karlsander/paper-slot-processor/docs/images/v1.8-half-taper-base.png

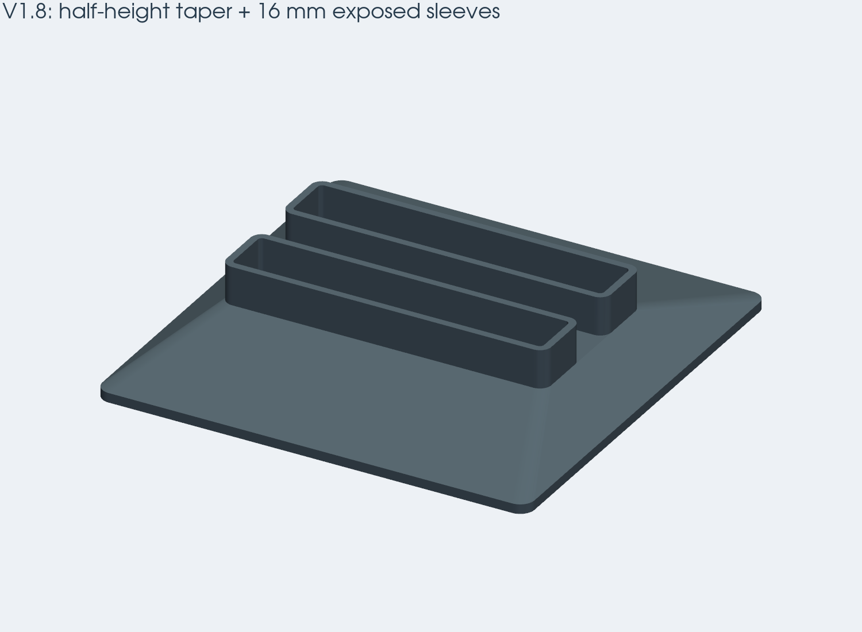
docs/images/v1.8-half-taper-base.png
