karlsander/paper-slot-processor/docs/negative-carrier-b2/forces/force-summary.png

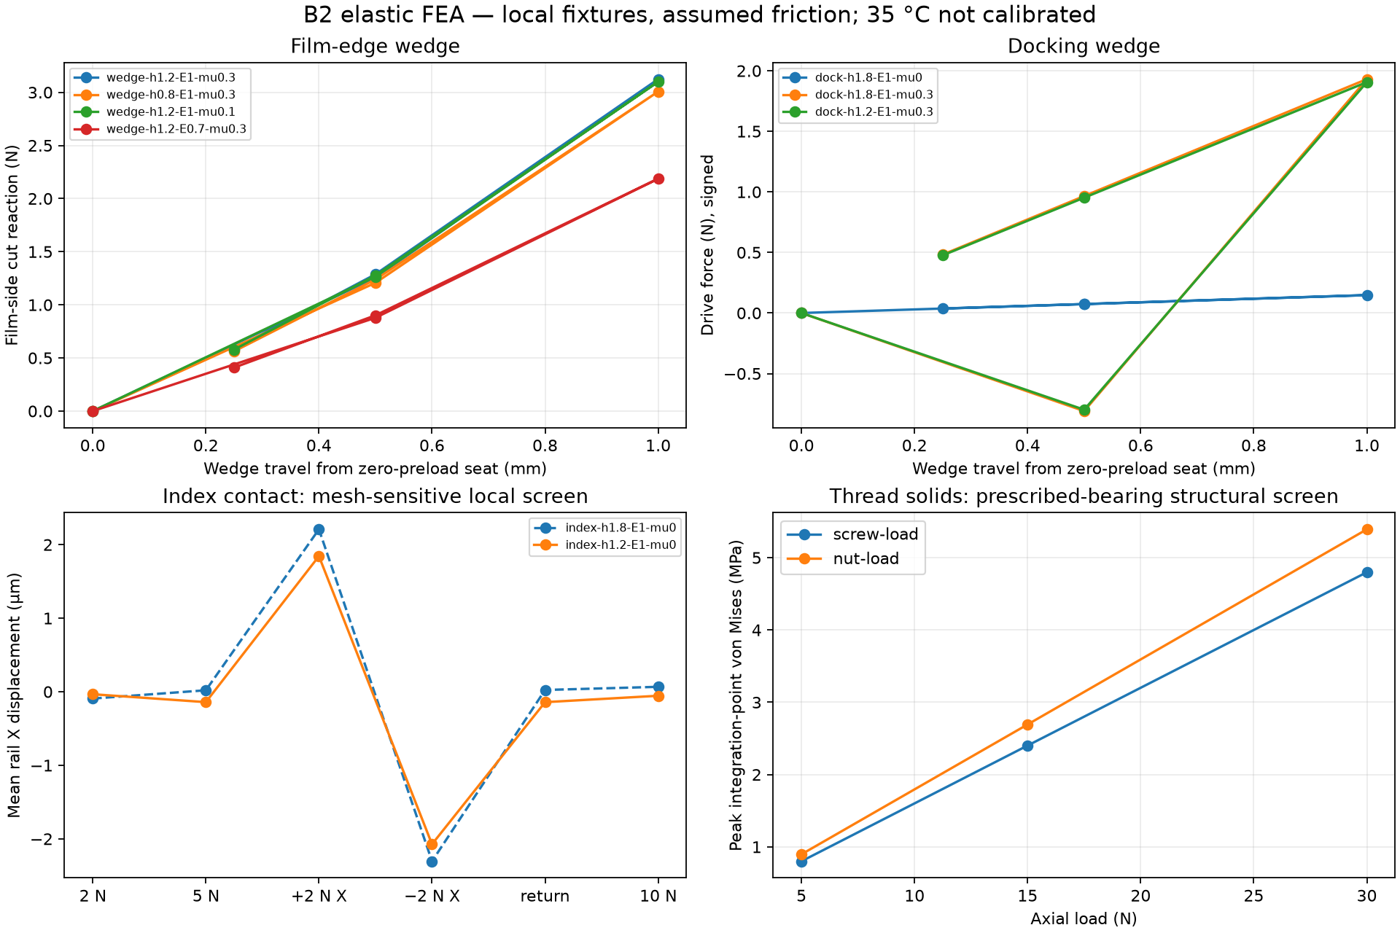
docs/negative-carrier-b2/forces/force-summary.png
