karlsander/paper-slot-processor/docs/negative-carrier-b2/videos/04-dock-preview.png

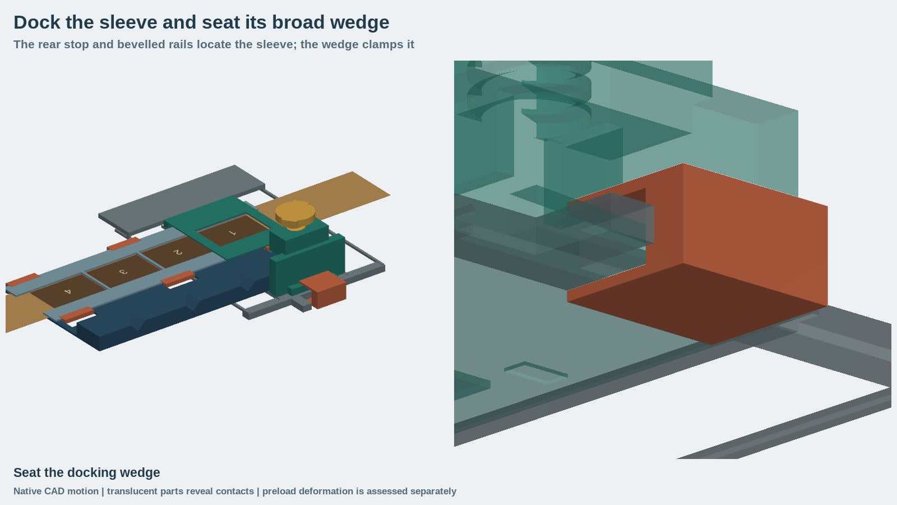
docs/negative-carrier-b2/videos/04-dock-preview.png
