karlsander/paper-slot-processor/docs/negative-carrier-b/forces/clip-catch-0.22.png

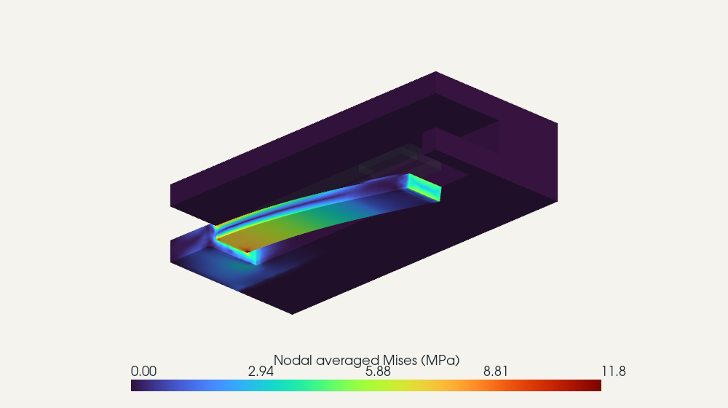
docs/negative-carrier-b/forces/clip-catch-0.22.png
