karlsander/paper-slot-processor/docs/negative-carrier-b/forces/contact-0.4-0.3-side1-compare.png

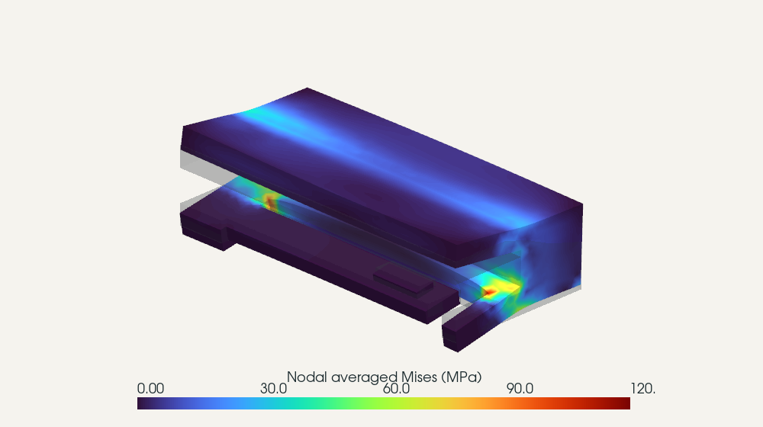
docs/negative-carrier-b/forces/contact-0.4-0.3-side1-compare.png
