karlsander/paper-slot-processor/docs/negative-carrier-b/forces/contact-0.55-0.3-side1-mates20-mortar-compare.png

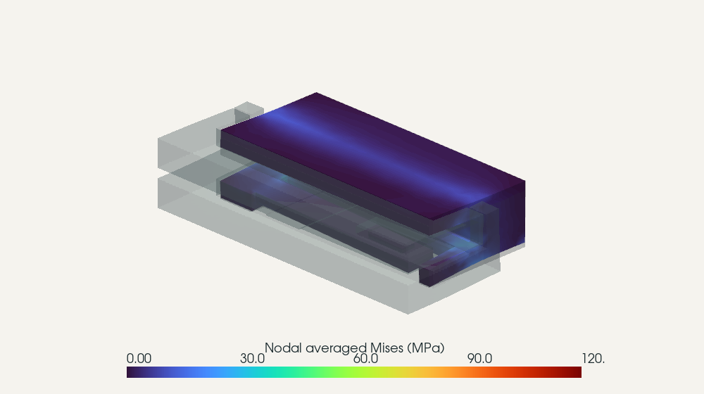
docs/negative-carrier-b/forces/contact-0.55-0.3-side1-mates20-mortar-compare.png
