karlsander/paper-slot-processor/docs/negative-carrier-b/forces/index-tip-0.085.png

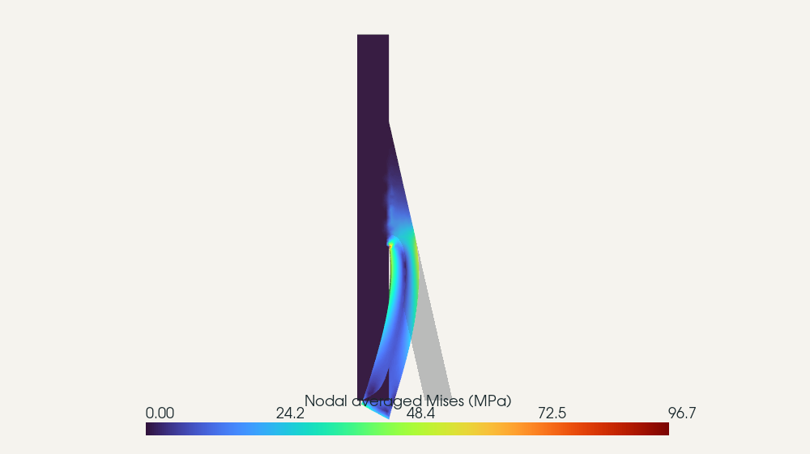
docs/negative-carrier-b/forces/index-tip-0.085.png
