karlsander/paper-slot-processor/docs/negative-carrier-b/forces/jaw-compliance.png

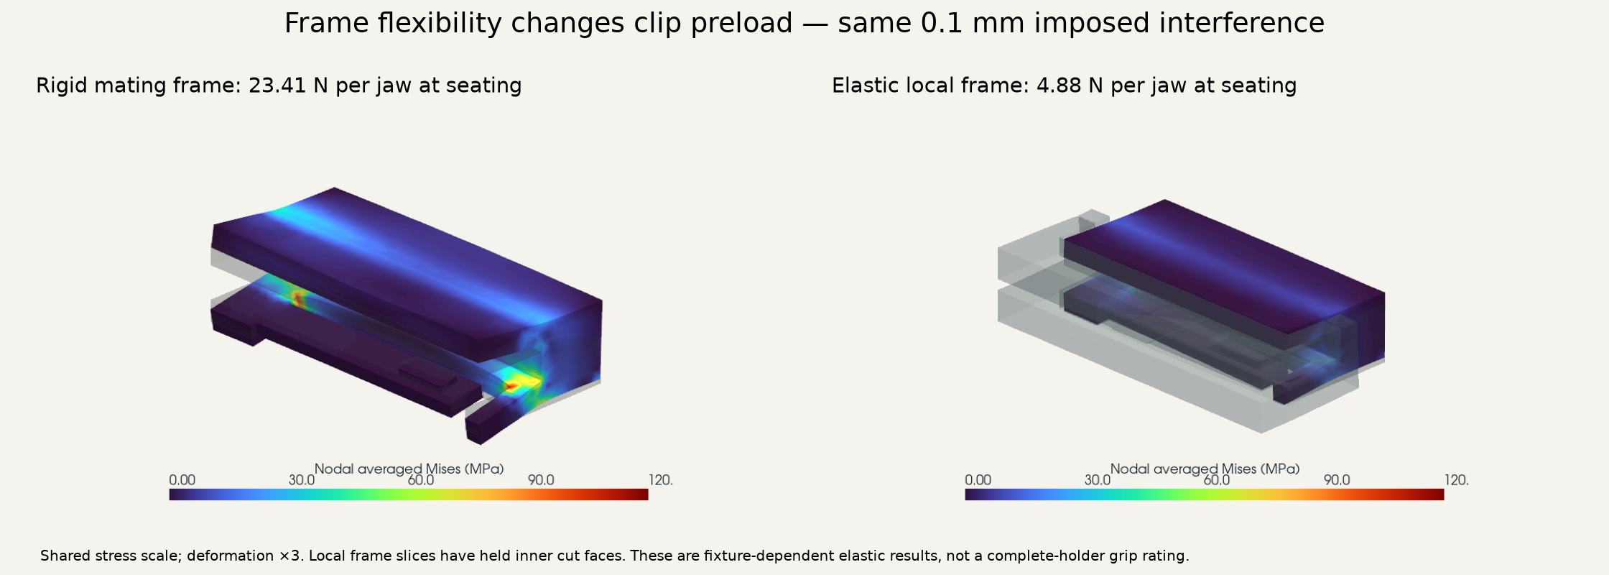
docs/negative-carrier-b/forces/jaw-compliance.png
