karlsander/paper-slot-processor/docs/negative-carrier-b/forces/roof-0.2.png

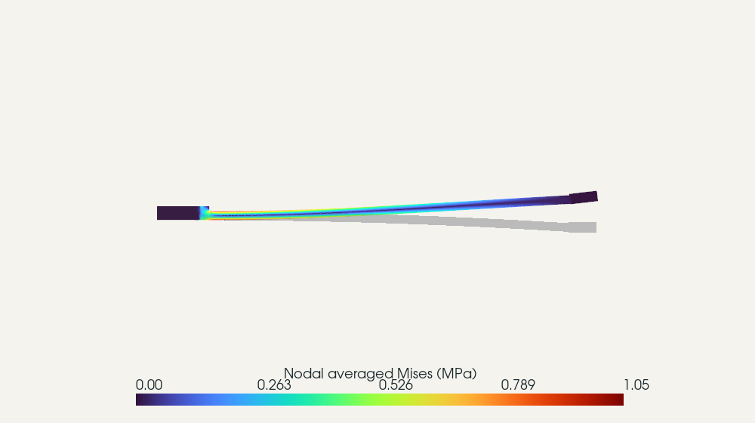
docs/negative-carrier-b/forces/roof-0.2.png
