karlsander/paper-slot-processor/docs/negative-carrier-b/forces/stress-overview.png

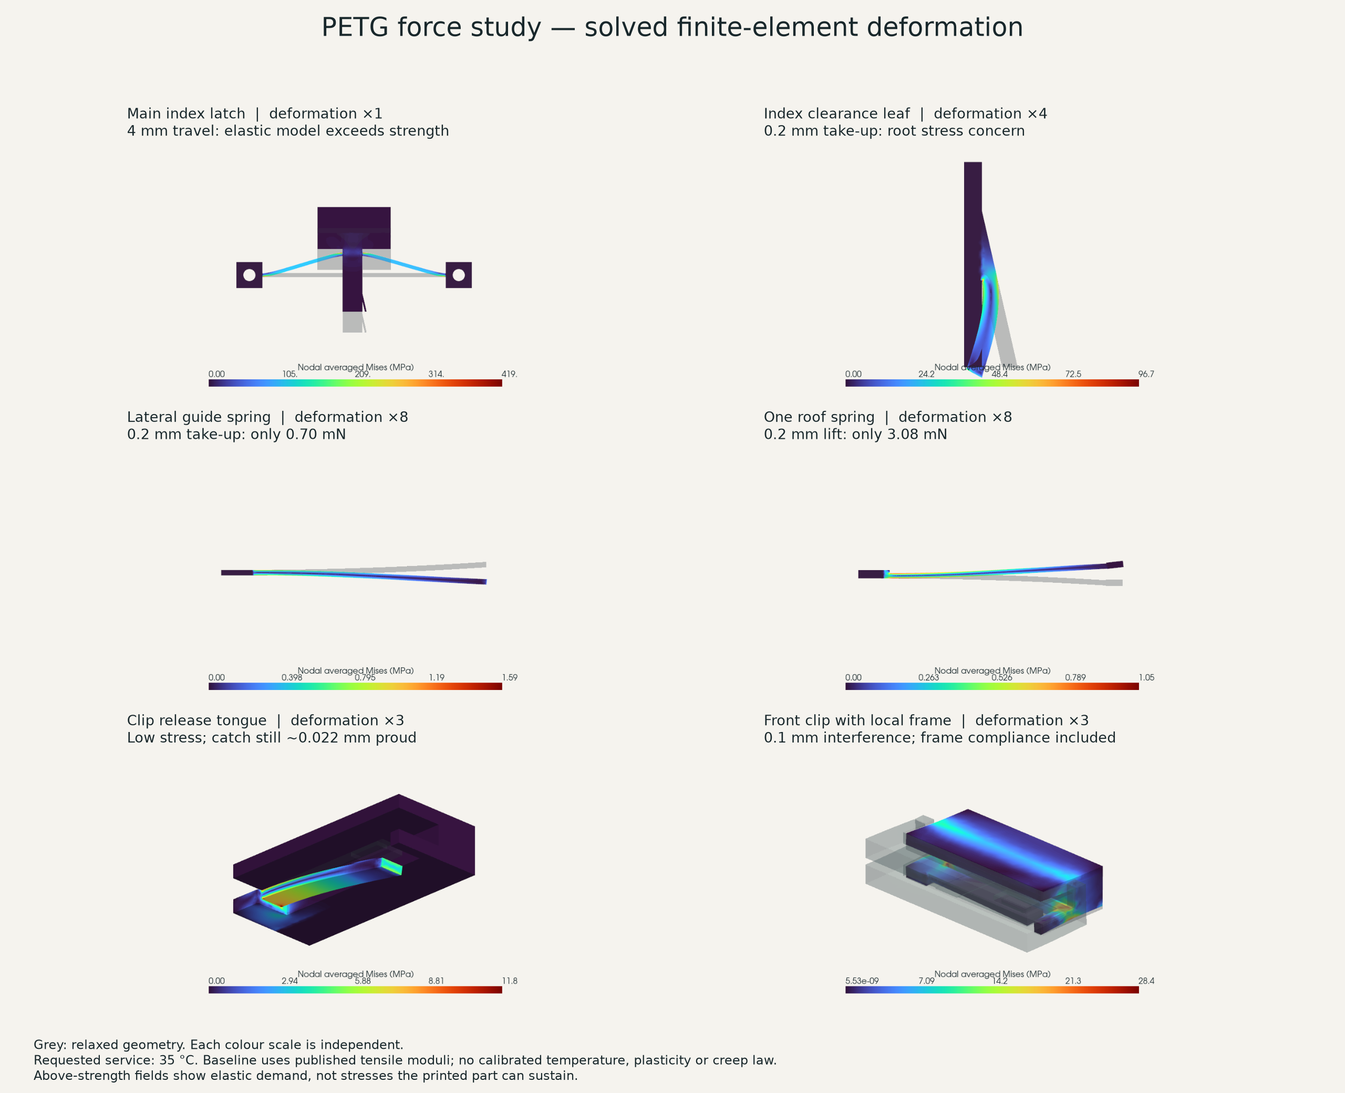
docs/negative-carrier-b/forces/stress-overview.png
