karlsander/paper-slot-processor/docs/negative-carrier-b/mechanics/03-cap-lock-poster.jpg

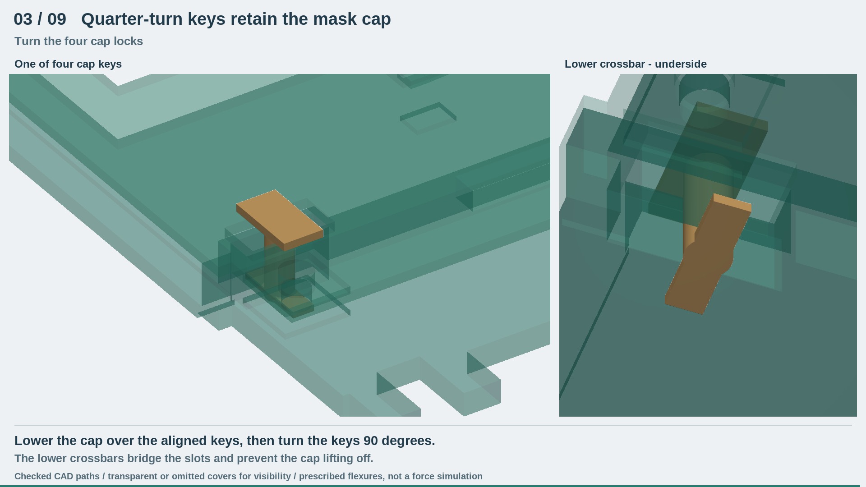
docs/negative-carrier-b/mechanics/03-cap-lock-poster.jpg
