karlsander/paper-slot-processor/docs/negative-carrier-b/mechanics/04-docking-lock-poster.jpg

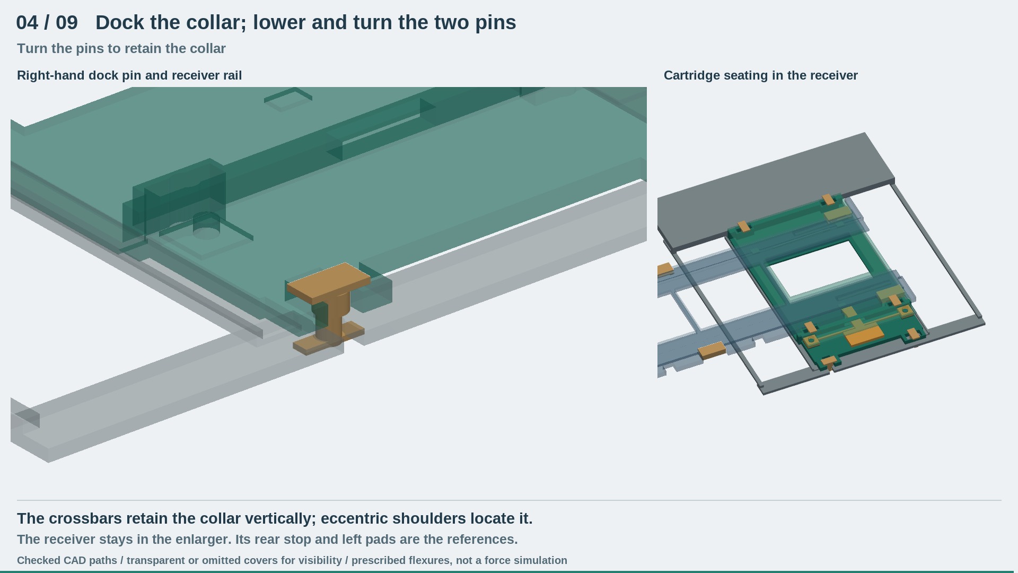
docs/negative-carrier-b/mechanics/04-docking-lock-poster.jpg
