karlsander/paper-slot-processor/docs/negative-carrier-b/mechanics/05-index-latch-poster.jpg

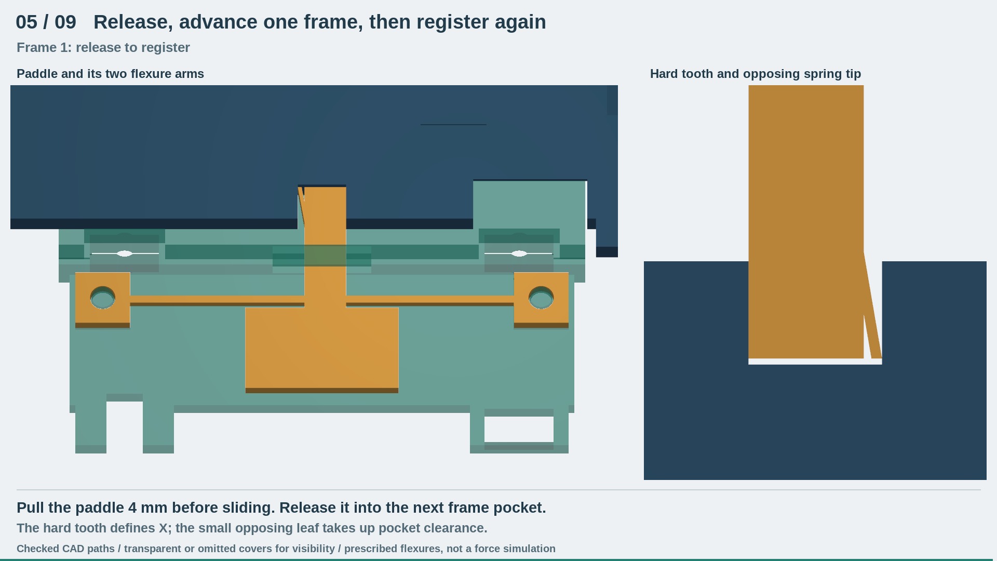
docs/negative-carrier-b/mechanics/05-index-latch-poster.jpg
