karlsander/paper-slot-processor/docs/negative-carrier-b/mechanics/08-fixed-mask-poster.jpg

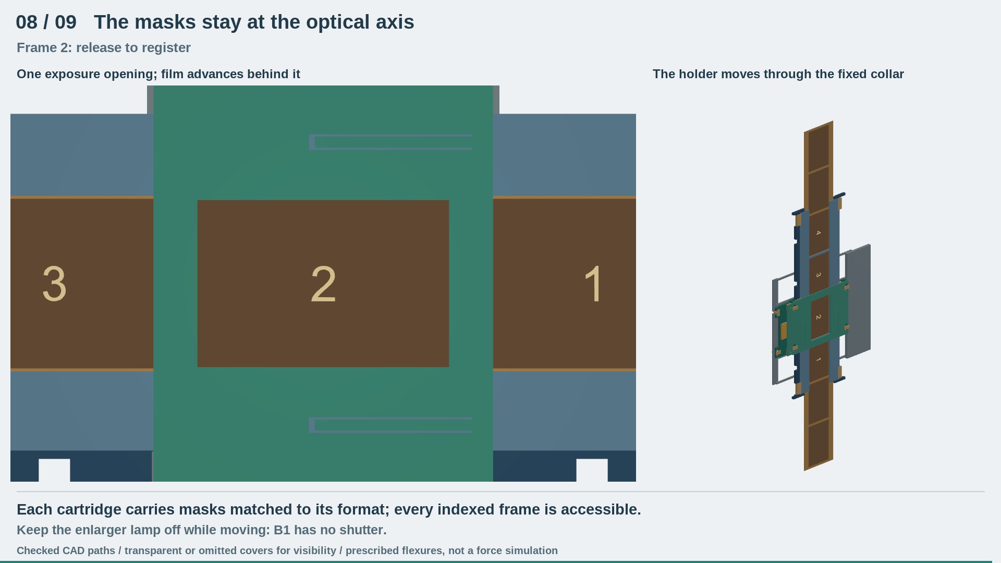
docs/negative-carrier-b/mechanics/08-fixed-mask-poster.jpg
