karlsander/paper-slot-processor/docs/negative-carrier-b/videos/110-advance-poster.jpg

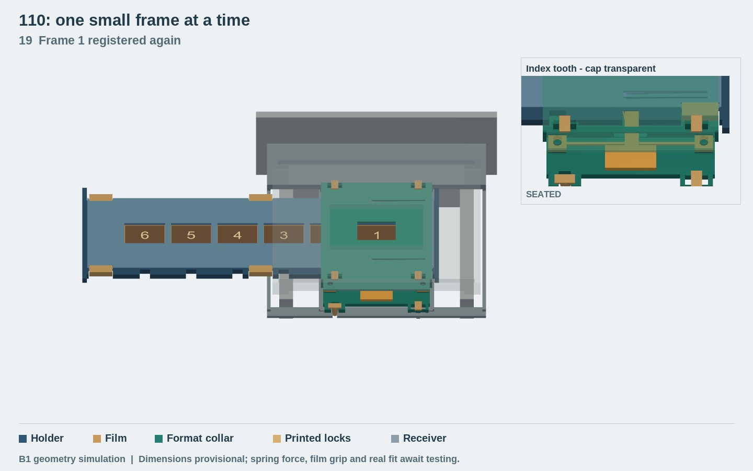
docs/negative-carrier-b/videos/110-advance-poster.jpg
