karlsander/paper-slot-processor/docs/negative-carrier-b/videos/135-advance-poster.jpg

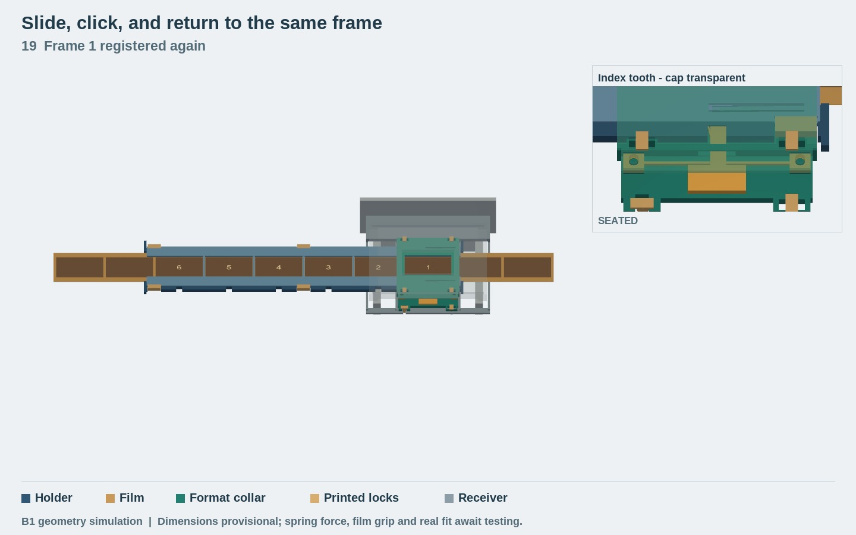
docs/negative-carrier-b/videos/135-advance-poster.jpg
