karlsander/paper-slot-processor/docs/negative-carrier-b/videos/135-dock-poster.jpg

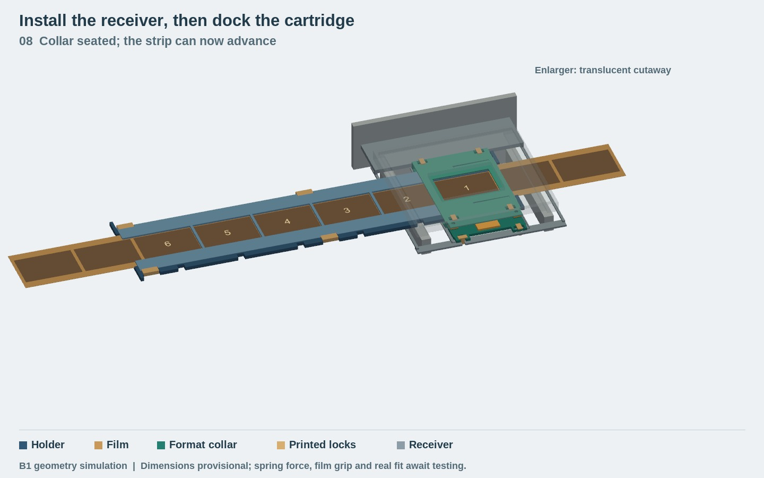
docs/negative-carrier-b/videos/135-dock-poster.jpg
