karlsander/paper-slot-processor/docs/negative-carrier-b/videos/135-load-poster.jpg

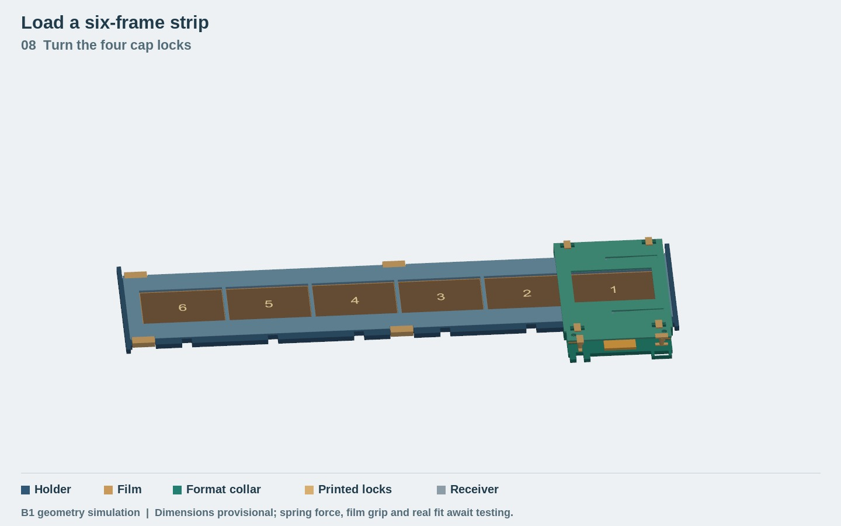
docs/negative-carrier-b/videos/135-load-poster.jpg
