karlsander/paper-slot-processor/paper_slot_processor_slit_caps.scad

// Complete set of slot covers: flat outside faces on bed, locating ribs up.
include <lib/parameters.scad>
include <lib/geometry.scad>
include <lib/caps.scad>
validate_parameters() slit_cap_plate();
