karlsander/paper-slot-processor/docs/negative-carrier-b/mechanics/06-guides-poster.jpg

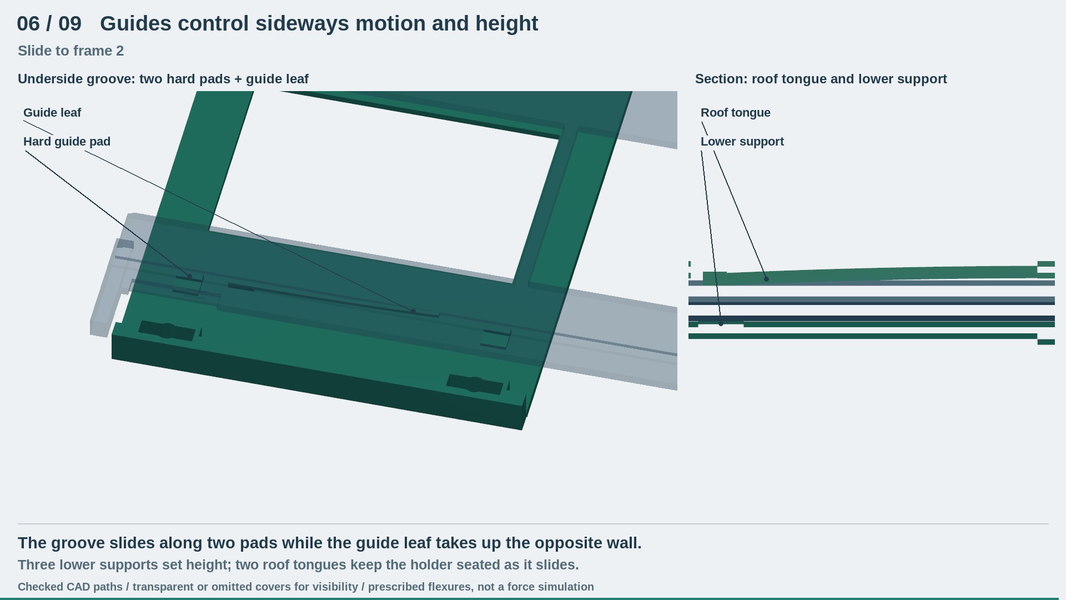
docs/negative-carrier-b/mechanics/06-guides-poster.jpg
