karlsander/paper-slot-processor/docs/negative-carrier-b/videos/110-advance-step-09.jpg

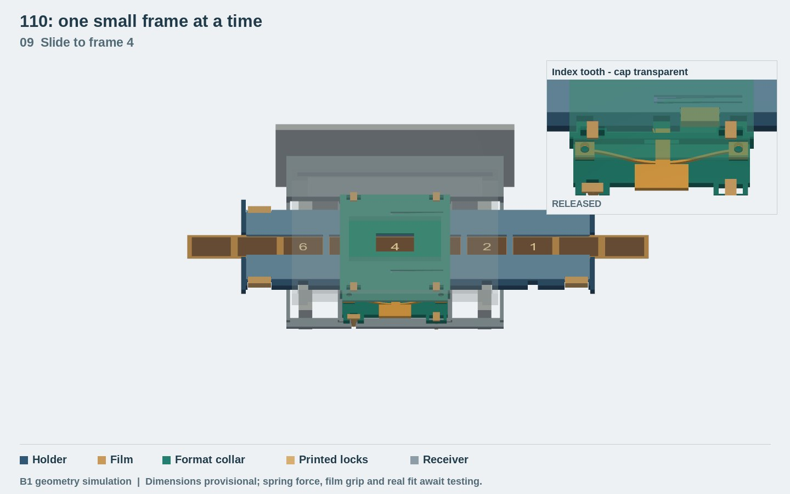
docs/negative-carrier-b/videos/110-advance-step-09.jpg
