karlsander/paper-slot-processor/docs/negative-carrier-b/videos/135-advance-step-05.jpg

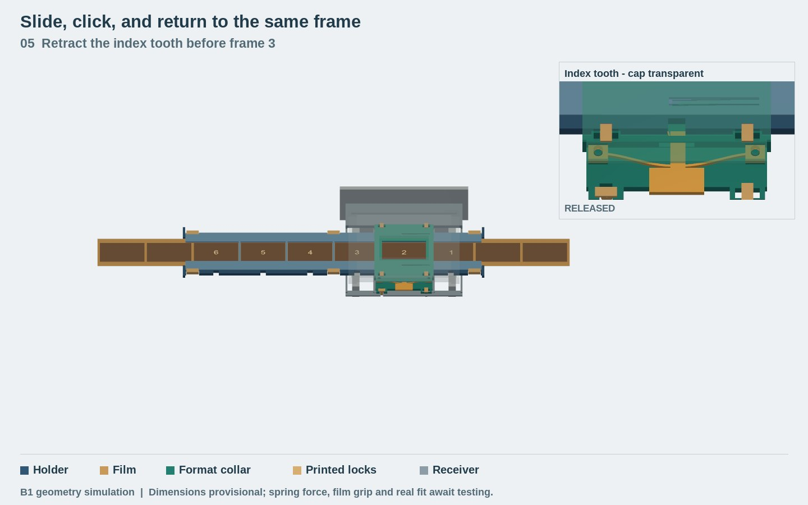
docs/negative-carrier-b/videos/135-advance-step-05.jpg
