karlsander/paper-slot-processor/docs/negative-carrier-b/videos/135-dock-step-01.jpg

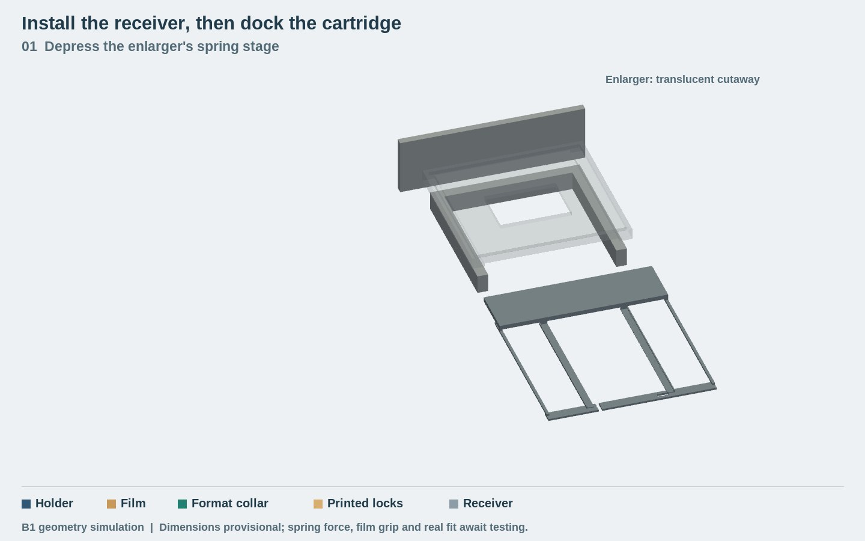
docs/negative-carrier-b/videos/135-dock-step-01.jpg
