karlsander/paper-slot-processor/docs/negative-carrier-b/videos/135-load-step-03.jpg

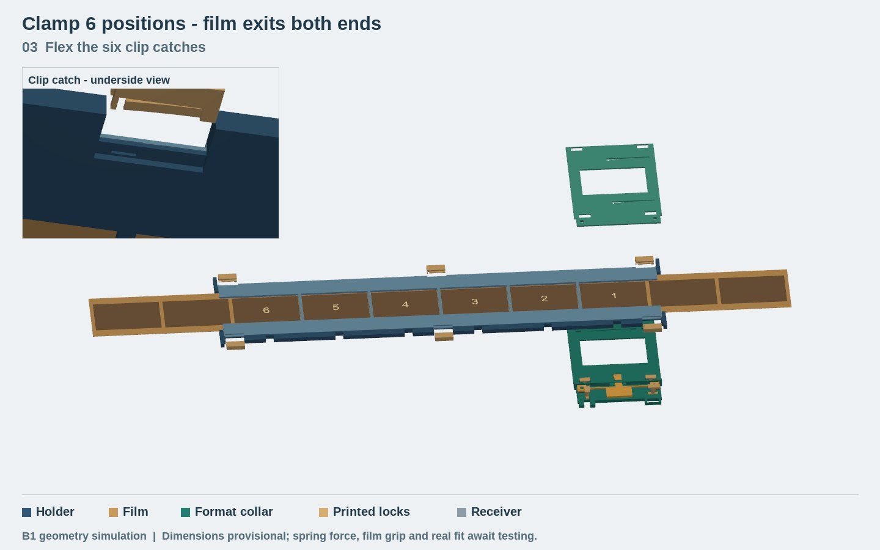
docs/negative-carrier-b/videos/135-load-step-03.jpg
