karlsander/paper-slot-processor/docs/negative-carrier-b/videos/135-reposition-step-06.jpg

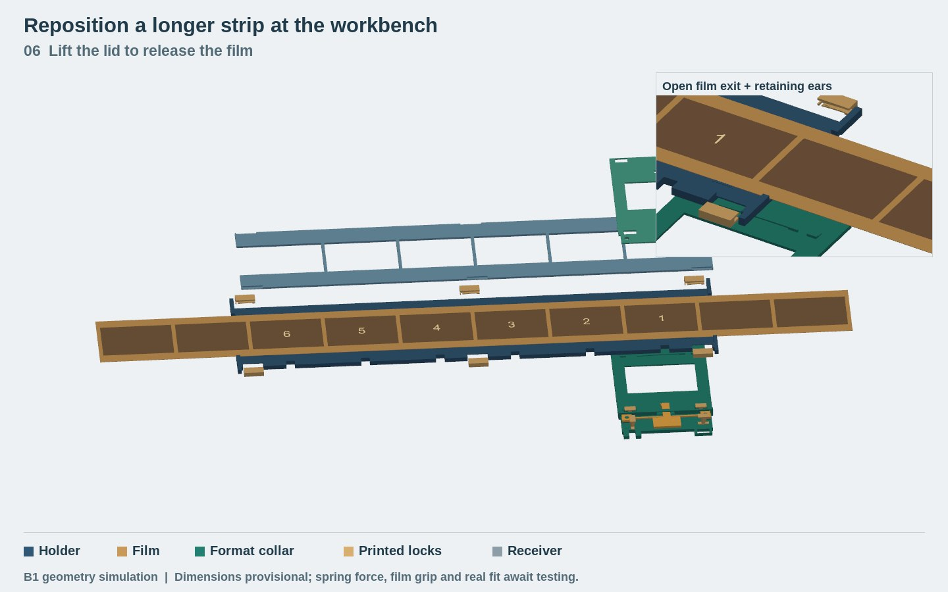
docs/negative-carrier-b/videos/135-reposition-step-06.jpg
