karlsander/paper-slot-processor/simulation/physics/evidence/2026-10-28/tapered-assembly.png

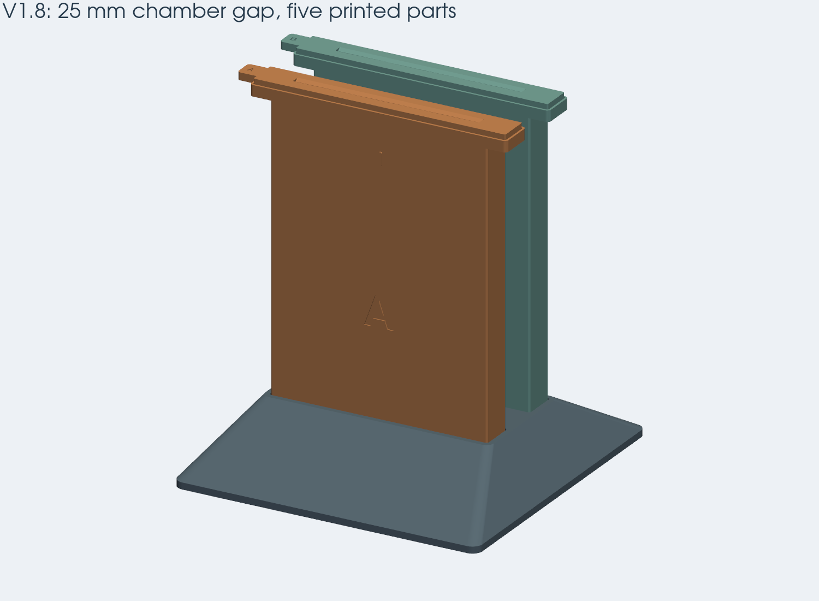
simulation/physics/evidence/2026-10-28/tapered-assembly.png
