karlsander/paper-slot-processor/(commit log)

2026-06-14 Add paper slot processor model
    [120_medium_format_spool.scad, 120_medium_format_spool.stl, paper_slot_processor.scad, paper_slot_processor.stl]
2026-06-25 Add .gitignore for build output and tooling cruft
    Ignore the build/ output tree, Python venv/caches, the Bambu CLI
    result.json sidecar, macOS/editor files. Tracked .scad/.stl/.skill
    sources are deliberately not ignored.
2026-06-25 Add inlet/slit caps and handling tong; fit inlet to the caps
    Add three companion parts for paper_slot_processor.scad:
    - paper_slot_processor_inlet_caps.scad: push-in caps for the chemistry inlets
    - paper_slot_processor_slit_caps.scad: drop-in caps that close the paper slots
    - paper_slot_processor_tong.scad: squeeze tong with a sliding lock collar
    Adjust the processor's inlet/clip geometry to seat the caps: add a raised
    inlet cap land (inlet_cap_land_height) and a clip-channel splash wall
    (inlet_splash_wall_thickness) so the paper-clip slot stops at the inlet
    instead of spanning the full chamber width.
    [paper_slot_processor.scad, paper_slot_processor_inlet_caps.scad, paper_slot_processor_slit_caps.scad, paper_slot_processor_tong.scad]
2026-06-25 Remove 120 spool model and committed STL meshes
    Drop the unused 120 medium-format film-spool model and the tracked .stl
    mesh exports. Meshes are regenerated into build/ on demand and are now
    gitignored, so they no longer belong in version control.
    [120_medium_format_spool.scad, 120_medium_format_spool.stl, paper_slot_processor.stl]
2026-06-26 Reshape clip chambers and inlet funnels; refit caps
    paper_slot_processor.scad:
    - Shallower clip pocket (24 -> 10 mm) so the clip is easy to reach.
    - Slit top is now a steep funnel down to a short 1 mm wiper land, so it is
    easy to find and chemistry drains back into the chamber.
    - Clip chambers are pill-shaped with rounded-over top rims (lofted capsule)
    for easier cleaning and a nicer feel.
    - Inlets alternate sides (inlet_alternate_sides), threaded per slot through
    the inlet/clip helpers and side-rib logic (merged from the
    vigilant-wescoff worktree).
    - Bigger inlet funnels: 30 mm mouth bore with walls tapering thinner toward
    the top (inlet_wall_top), flaring more while staying suppo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
    [paper_slot_processor.scad, paper_slot_processor_inlet_caps.scad, paper_slot_processor_slit_caps.scad]
2026-10-19 Engrave chamber names and calculated rounded mixing volumes
2026-10-19 Redesign inlets with swept round bores and calibrated fill cues
2026-10-20 Build v2 modular paper processor for 102 mm rolls (#4)
    * Build modular v2 vessels and interchangeable paper guides
    * Finish modular processor heater frame, parametric viewer and print bundles
2026-10-20 Restore parallel slots with independent 5 W heater modules (#5)
2026-10-28 Simplify v1.8 to five parts with magnetic tops and internal fill ridge (#11)
2026-10-28 Refine five-part v1.8 base and validate printing, fluid fill and heater sizing (#12)
    * Add OpenFOAM bath physics and PETG nozzle audits; strengthen magnet edges
    * Taper full-bed base, tighten chamber spacing and complete physics evidence
2026-10-28 Refine v1.8 sleeve base and prepare verified Bambu Studio projects (#13)
    * Expose straight sleeves above half-height base taper
    * Generate verified five-plate Bambu Studio projects for both nozzles
    * Account for Bambu recentering when verifying saved mesh geometry
2026-10-31 Give printed closure clips a clamping preload
